FelizCoder/crewstand.hat/CHANGELOG.md

# Changelog

## [1.1.1](https://github.com/FelizCoder/crewstand.hat/compare/v1.1.0...v1.1.1) (2025-02-19)

### Bug Fixes

* **relais-gpio:** use GPIO26 & 19 ([f3a6f33](https://github.com/FelizCoder/crewstand.hat/commit/f3a6f33be471cfa0588ff4acc8377d35cb9e9b51)), closes [#13](https://github.com/FelizCoder/crewstand.hat/issues/13)

## [1.1.0](https://github.com/FelizCoder/crewstand.hat/compare/v1.0.1...v1.1.0) (2025-02-12)

### Features

* switch to professional PCB manufacturing service ([04fce64](https://github.com/FelizCoder/crewstand.hat/commit/04fce6482bde8b3229f7275ea6469fb067c6a64b)), closes [#7](https://github.com/FelizCoder/crewstand.hat/issues/7)

## [1.0.1](https://github.com/FelizCoder/crewstand.hat/compare/v1.0.0...v1.0.1) (2025-02-12)

### Bug Fixes

* **Sensors:** correct resistor placement for analog sensor readings ([b13b00f](https://github.com/FelizCoder/crewstand.hat/commit/b13b00f41ccdcd93f972678ce98eec2645bcbf4e)), closes [#6](https://github.com/FelizCoder/crewstand.hat/issues/6)

## [1.0.0](https://github.com/FelizCoder/crewstand.hat/compare/v1.0.0...v1.0.0) (2025-02-12)

### ⚠ BREAKING CHANGES

* placement of the Parts

### Features

* add mounting holes ([e6fcd68](https://github.com/FelizCoder/crewstand.hat/commit/e6fcd6856ed51134eaadee23ef0d4585478b6746))
* adopt voroni design ([d55c532](https://github.com/FelizCoder/crewstand.hat/commit/d55c53247b90d5069dac3a5085047876cc75d758))
* initial design ([1deba11](https://github.com/FelizCoder/crewstand.hat/commit/1deba11efad4ecdd8dbeb2b8a1ba4530150f91dc))
* reorder for bottom placement ([3ecbc56](https://github.com/FelizCoder/crewstand.hat/commit/3ecbc56880dbe83702e1db96145a0ecee450222e))
* use jst connectors ([ae1314e](https://github.com/FelizCoder/crewstand.hat/commit/ae1314e1b4873558af70e828da93c76f97db8ebc)), closes [#2](https://github.com/FelizCoder/crewstand.hat/issues/2)

### Miscellaneous Chores

* define release ([ff37217](https://github.com/FelizCoder/crewstand.hat/commit/ff3721725673ab0528a9566c0fe84ddae8fd85bc))

## 1.0.0 (2025-02-05)

### Features

* initial design ([1deba11](https://github.com/FelizCoder/crewstand.hat/commit/1deba11efad4ecdd8dbeb2b8a1ba4530150f91dc))
