FelizCoder/crewstand.hat/crewstand.hat.kicad_pcb

## KiCad design crewstand.hat.kicad_pcb (2025-02-19)

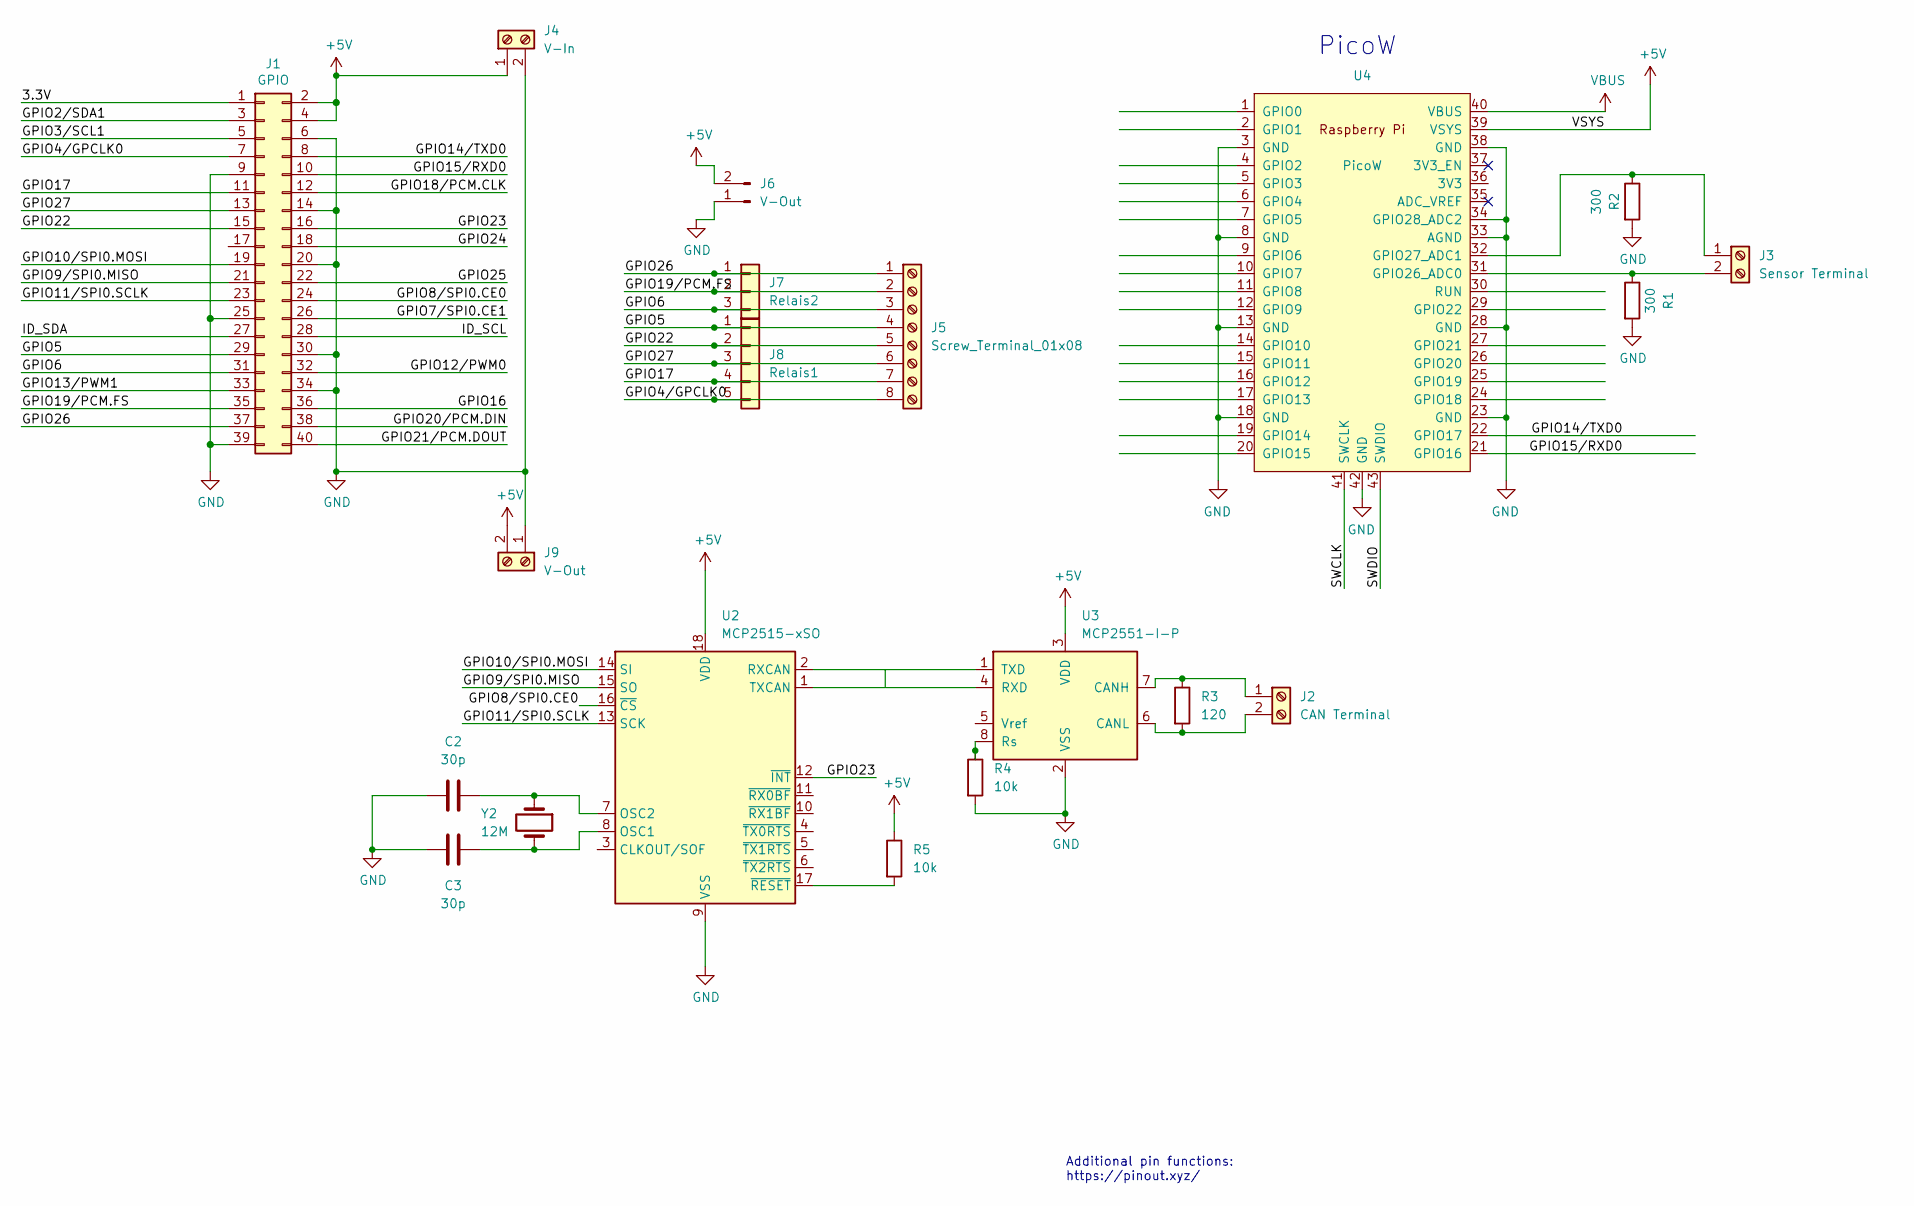
[picture p1: schematic crewstand.hat.kicad_sch]

Parts:
C2, C3: 30p; C_Disc_D3.4mm_W2.1mm_P2.50mm
J1: GPIO; PinSocket_2x20_P2.54mm_Vertical
J2: CAN Terminal; TerminalBlock_bornier-2_P5.08mm
J3: Sensor Terminal; TerminalBlock_bornier-2_P5.08mm
J4: V-In; TerminalBlock_bornier-2_P5.08mm
J5: Screw_Terminal_01x08; TerminalBlock_bornier-8_P5.08mm
J6: V-Out; JST_XH_B2B-XH-A_1x02_P2.50mm_Vertical
J7: Relais2; JST_XH_B3B-XH-A_1x03_P2.50mm_Vertical
J8: Relais1; JST_XH_B5B-XH-A_1x05_P2.50mm_Vertical
J9: V-Out; TerminalBlock_bornier-2_P5.08mm
R1, R2: 300; R_Axial_DIN0204_L3.6mm_D1.6mm_P5.08mm_Horizontal
R3: 120; R_Axial_DIN0204_L3.6mm_D1.6mm_P5.08mm_Horizontal
R4, R5: 10k; R_Axial_DIN0204_L3.6mm_D1.6mm_P5.08mm_Horizontal
U2: MCP2515-xSO; DIP-18_W7.62mm
U3: MCP2551-I-P; DIP-8_W7.62mm
U4: PicoW; RPi_PicoW_SMD_TH
Y2: 12M; Crystal_HC49-U_Vertical

Connections:
+5V: J1.2, J1.4, J4.1, J6.2, J9.2, R5.1, U2.18 (VDD), U3.3 (VDD), U4.39 (VSYS)
/3.3V: J1.1
/GPIO2/SDA1: J1.3
/GPIO3/SCL1: J1.5
/GPIO4/GPCLK0: J1.7, J5.8, J8.5
/GPIO5: J1.29, J5.4, J8.1
/GPIO6: J1.31, J5.3, J7.3
/GPIO7/SPI0.CE1: J1.26
/GPIO8/SPI0.CE0: J1.24, U2.16 (~CS)
/GPIO9/SPI0.MISO: J1.21, U2.15 (SO)
/GPIO10/SPI0.MOSI: J1.19, U2.14 (SI)
/GPIO11/SPI0.SCLK: J1.23, U2.13 (SCK)
/GPIO12/PWM0: J1.32
/GPIO13/PWM1: J1.33
/GPIO14/TXD0: J1.8, U4.22 (GPIO17)
/GPIO15/RXD0: J1.10, U4.21 (GPIO16)
/GPIO16: J1.36
/GPIO17: J1.11, J5.7, J8.4
/GPIO18/PCM.CLK: J1.12
/GPIO19/PCM.FS: J1.35, J5.2, J7.2
/GPIO20/PCM.DIN: J1.38
/GPIO21/PCM.DOUT: J1.40
/GPIO22: J1.15, J5.5, J8.2
/GPIO23: J1.16, U2.12 (~INT)
/GPIO24: J1.18
/GPIO25: J1.22
/GPIO26: J1.37, J5.1, J7.1
/GPIO27: J1.13, J5.6, J8.3
/ID_SCL: J1.28
/ID_SDA: J1.27
/SWCLK: U4.41 (SWCLK)
/SWDIO: U4.43 (SWDIO)
GND: C2.2, C3.2, J1.6, J1.9, J1.14, J1.20, J1.25, J1.30, J1.34, J1.39, J4.2, J6.1, J9.1, R1.2, R2.2, R4.2, U2.9 (VSS), U3.2 (VSS), U4.3 (GND), U4.8 (GND), U4.13 (GND), U4.18 (GND), U4.23 (GND), U4.28 (GND), U4.33 (AGND), U4.34 (GPIO28_ADC2), U4.38 (GND), U4.42 (GND)
unnamed: J2.1, R3.1, U3.7 (CANH)
unnamed: J2.2, R3.2, U3.6 (CANL)
unnamed: J3.1, R2.1, U4.32 (GPIO27_ADC1)
unnamed: J3.2, R1.1, U4.31 (GPIO26_ADC0)
unnamed: C3.1, U2.8 (OSC1), Y2.2
unnamed: C2.1, U2.7 (OSC2), Y2.1
unnamed: U2.2 (RXCAN), U3.1 (TXD)
unnamed: U2.1 (TXCAN), U3.4 (RXD)
unnamed: R5.2, U2.17 (~RESET)
unnamed: R4.1, U3.8 (Rs)
VBUS: U4.40 (VBUS)

Notes on the sheet:
PicoW
Additional pin functions: https://pinout.xyz/

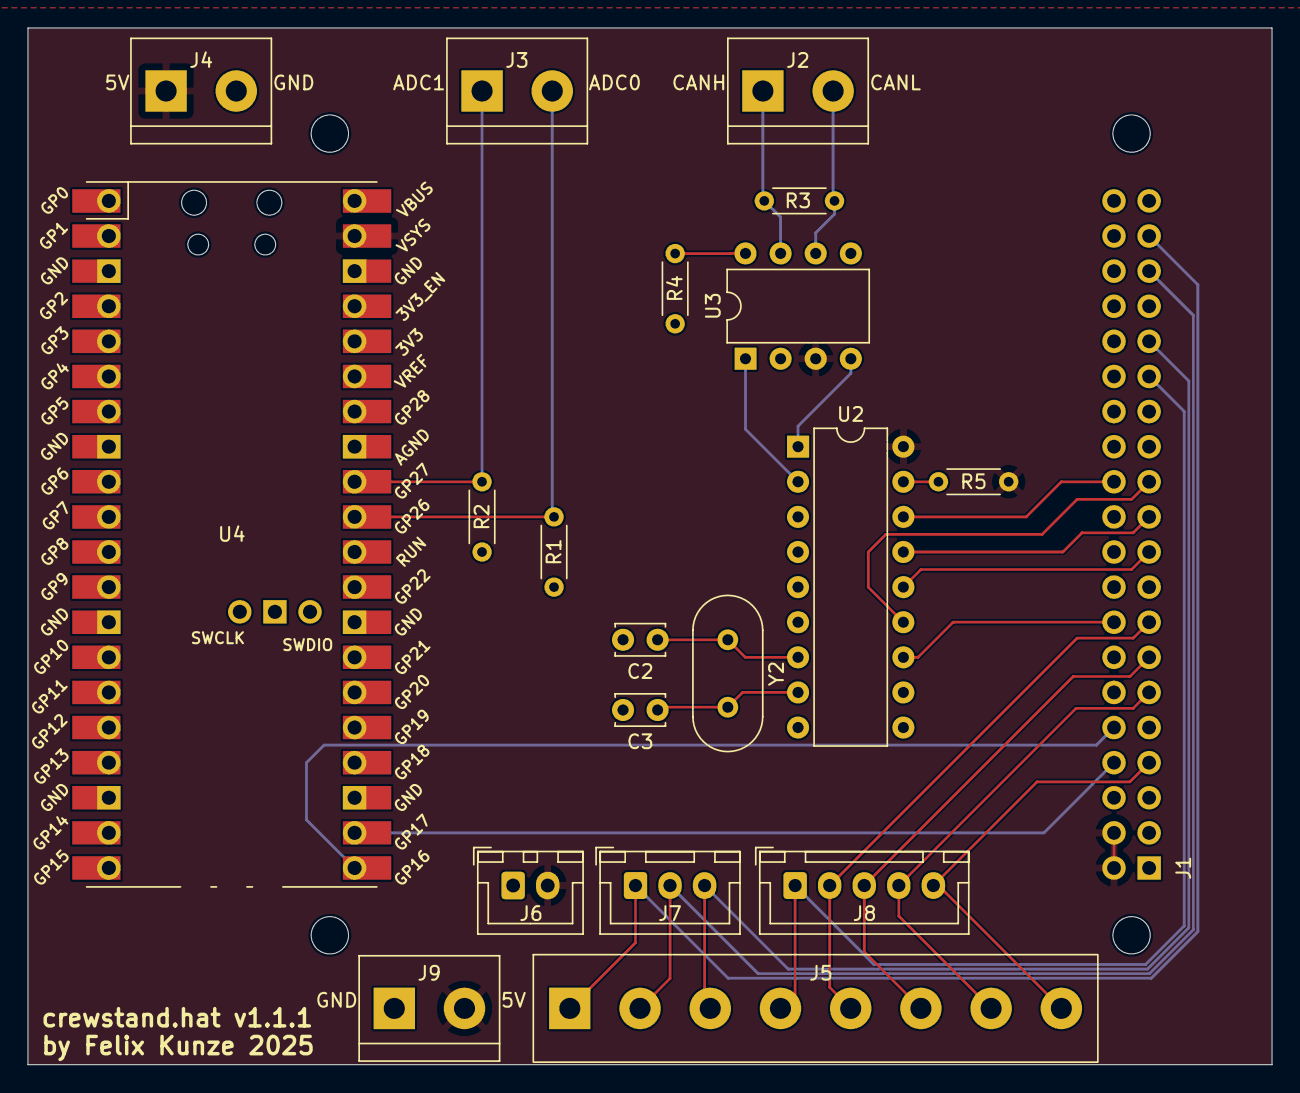
[picture p2: board crewstand.hat.kicad_pcb from above]

Board: 2 copper layers, 90.0 x 75.0 mm, 23 parts (1 on the bottom side), 27 nets.

Other parts of the board:
MH1, MH2: MountingHole_2.7mm_M2.5
REF4: MountingHole_2.7mm_M2.5
