FelizCoder/crewstand.hat/(threads)

Thread 2 (2025-02-05):

Design HAT for Rpi

FelizCoder, 2025-02-05:
## Components

- [ ] 2-CH CAN Terminal
- [ ] 8-CH Relais Terminal
- [ ] 5V-in Terminal
- [ ] 5V-out terminal
- [ ] 2-CH Sensor in Terminal
- [ ] Sensor Resistors
- [ ] Pico

- For CAN basically replicate the [CAN HAT of Waveshare](https://www.waveshare.com/wiki/RS485_CAN_HAT#Hardware_Description)
- Or just solder a [preassambled module](https://www.az-delivery.de/products/mcp2515-can-bus-modul?_pos=1&_psq=CAN&_ss=e&_v=1.0)
-

Thread 6 (2025-02-12):

Incorrect Current-to-Voltage Conversion Circuit for Analog Sensors

FelizCoder, 2025-02-12:
**Description**: The current placement of resistors for the analog sensor readings is incorrect. The circuit needs to be modified to properly convert the sensor's current output to a voltage that the ADC can read.

**Current incorrect configuration:**
```
Sensor +---R----+
                |
                ADC
```

**Required configuration**:
```
Sensor -------ADC
               |
               R
               |
              GND
```
**Technical Explanation**:

- The sensor outputs a proportional current signal
- The current flowing through R (pull-down resistor) creates a voltage drop according to Ohm's Law (V = I * R)
- This voltage is what the ADC should measure
- With the current configuration, we're not properly converting the current to a measurable voltage
**Impact**: The current configuration doesn't allow proper current-to-voltage conversion, leading to incorrect sensor readings.

**Required Changes**:

1. Move the resistors to be between the ADC input and GND
2. Ensure the sensor output, ADC input, and the upper leg of the resistor are connected at the same node
3. Connect the lower leg of the resistor to GND
Please update the schematic to reflect this correction.

Thread 7 (2025-02-12):

Switch from CNC milling to professional PCB manufacturing due to isolation issues

FelizCoder, 2025-02-12:
## Description
The CNC milling attempt for the Crewstand HAT PCB was unsuccessful due to insufficient isolation between pins. This manufacturing method has proven inadequate for the required precision of our design.

## Current Problems

Incomplete isolation between pins
Machine and tool accuracy limitations for our design requirements
Risk of shorts due to inadequate isolation

## Proposed Solution
Switch to professional PCB manufacturing service (e.g., PCBWay) for better quality and reliability.

## Action Items

- [ ]  Review current PCB design for manufacturing (DFM) requirements
- [ ]  Adjust design rules according to manufacturer specifications
- [ ]  Export Gerber files in proper format
- [ ]  Get manufacturing quotes from PCB manufacturers

Closed 2025-02-12.
