FelizCoder/crewstand.hat/(commit log)

2025-02-05 feat: initial design
    Release as: 0.0.0
    [crewstand.hat-Edge_Cuts.dxf, crewstand.hat-F_Cu.dxf, crewstand.hat.kicad_pcb, crewstand.hat.kicad_sch]
2025-02-12 feat: use jst connectors
    * update clearance and track width
    * Optimize placement and tracks
    issue #2
    [crewstand.hat.kicad_pcb, crewstand.hat.kicad_sch]
2025-02-12 feat: add mounting holes
    [crewstand.hat.kicad_pcb]
2025-02-12 feat: adopt voroni design
    * do not use GND fill to optimize for voroni design
    * voroni design for better milling
    * milling paths generated with [pcb2gcode](https://github.com/pcb2gcode/pcb2gcode)
    [crewstand.hat.kicad_pcb]
2025-02-12 feat!: reorder for bottom placement
    * Bottom placement needed to have connectors accessible on top
    * optimize trace width
    * optimise for voroni design
    * include [pcb2gcode](https://github.com/pcb2gcode/pcb2gcode) generated svg for cnc
    BREAKING CHANGE: Platine Layout for bottom
    placement of the Parts
    [crewstand.hat-Edge_Cuts.dxf, crewstand.hat-F_Cu.dxf, crewstand.hat.kicad_pcb, crewstand.hat.kicad_sch]
2025-02-12 fix(Sensors): correct resistor placement for analog sensor readings
    - Move pull-down resistors from sensor-to-ADC path to ADC-to-GND
    - Update schematic to implement proper current-to-voltage conversion
    Breaking Change: Yes
    - PCB layout updated
    - Existing boards will need rework to implement this fix
    Resolves: #6
    [crewstand.hat.kicad_pcb, crewstand.hat.kicad_sch]
2025-02-12 feat: switch to professional PCB manufacturing service
    - Update design rules for professional PCB manufacturing
    - Prepare files for PCBWay or similar manufacturer submission
    - use two layers for routing
    - use GND / 5V fill on layers
    - place silkscreen notes
    - add redundant screw terminal for relais board connection
    Resolves: #7
    [crewstand.hat.kicad_pcb, crewstand.hat.kicad_sch]
2025-02-19 fix(relais-gpio): use GPIO26 & 19
    - GPIO 2&3 where high on boot
    - ensures all pins are low until actively switched by backend
    - minor changes on routing and footprints
    issue #13
    [crewstand.hat.kicad_pcb, crewstand.hat.kicad_sch]
